Bladeson01/SMS-II-RGB-to-YPbPr/(list of files, cad)

Other CAD files:
lumberg_1503_13.stp
