Bladeson01/SMS-II-RGB-to-YPbPr/SMSII_Componentv3.kicad_pcb

## KiCad design SMSII_Componentv3.kicad_pcb (2021-07-04)

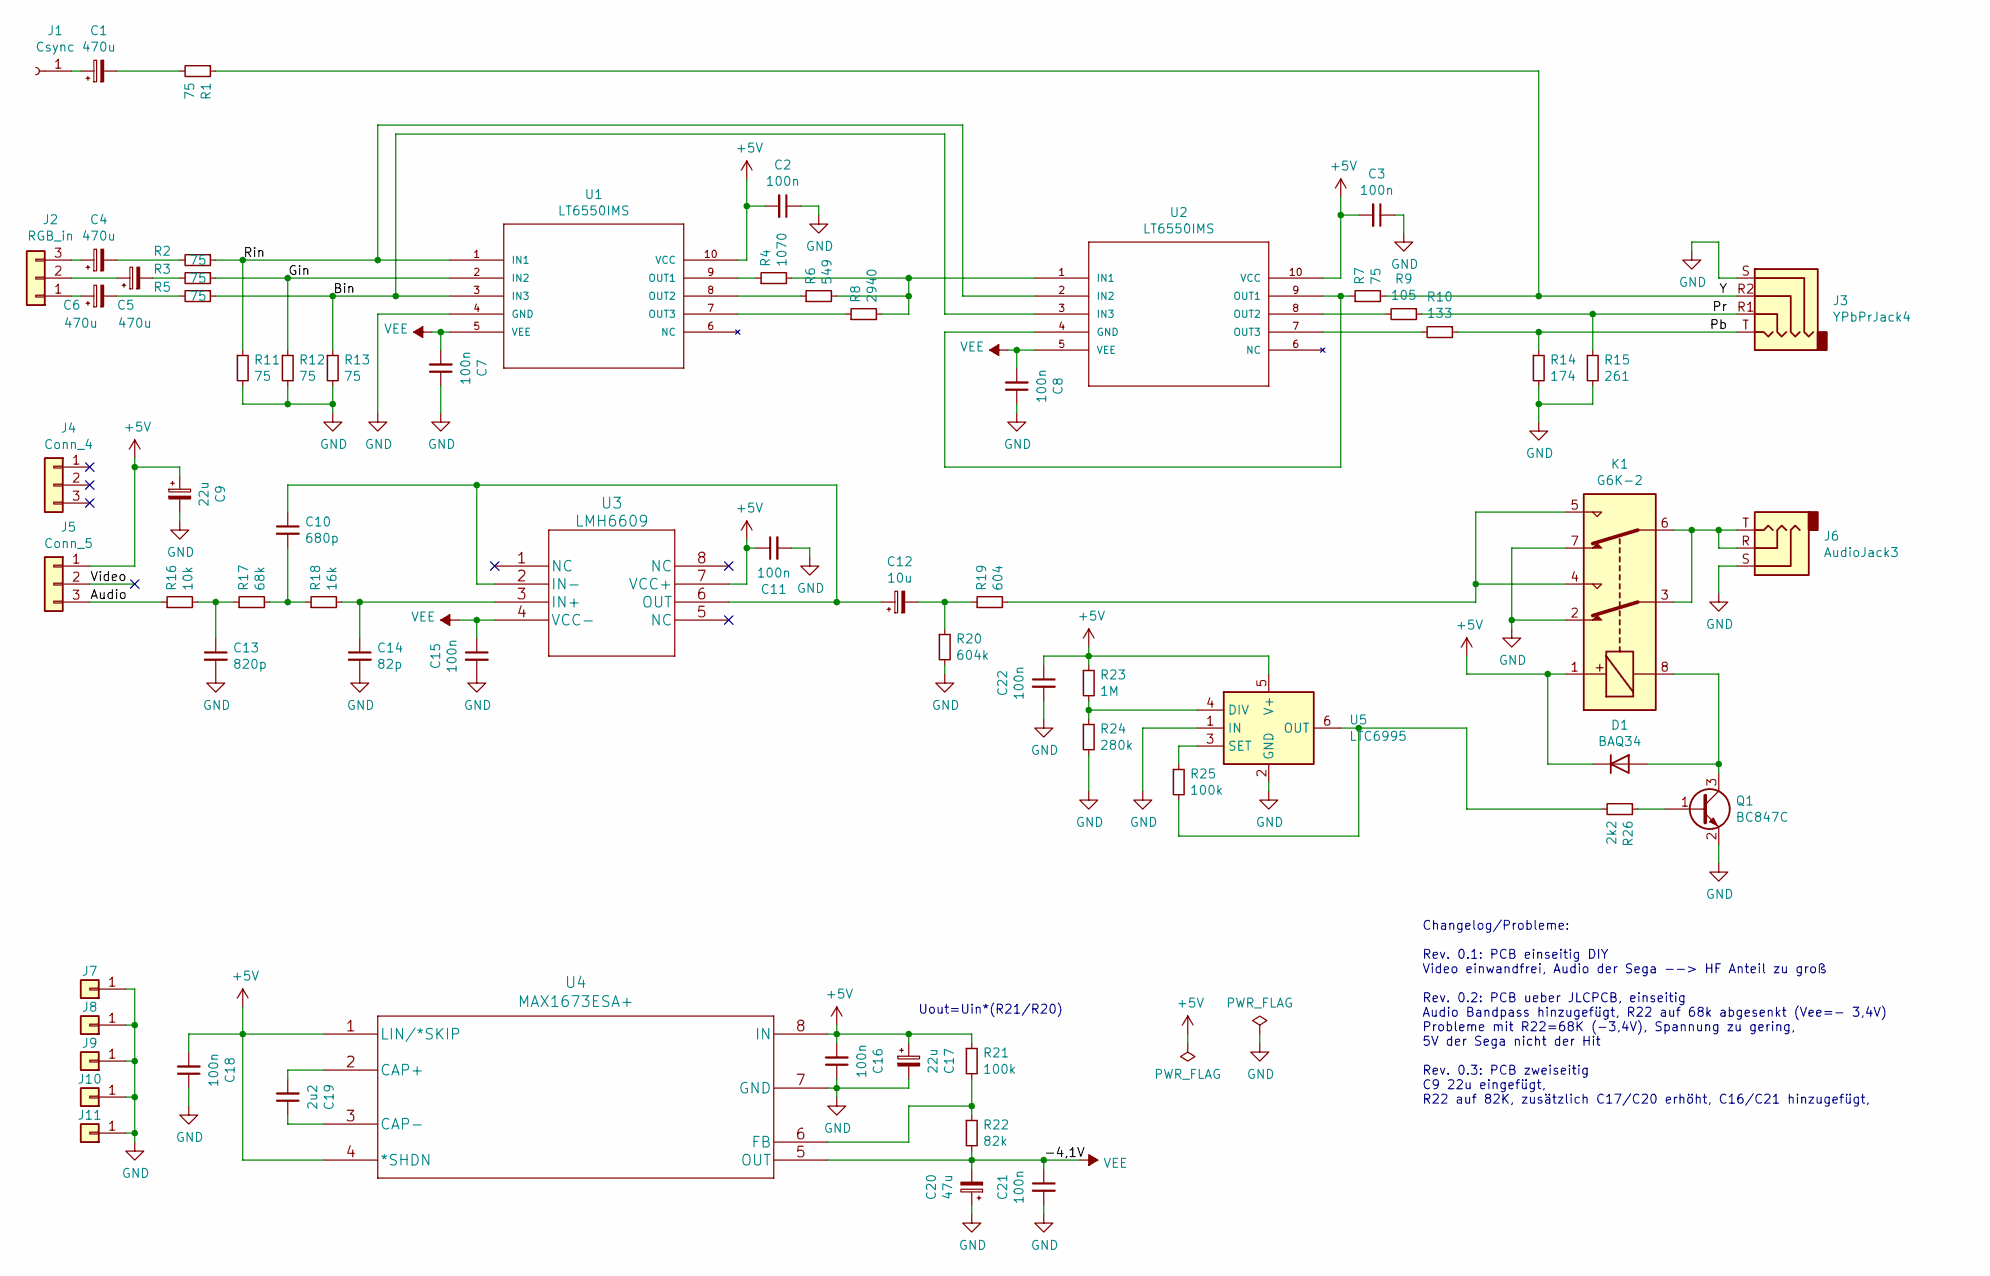
[picture p1: schematic SMSII_Componentv3.sch, SegaMS II -RGB to YPbPr]

Parts:
C1, C4, C5, C6: 470u; CP_Elec_6.3x7.7; LCSC C344072
C2, C3, C7, C8, C11, C15, C16, C18, C21, C22: 100n; C_0603_1608Metric_Pad1.05x0.95mm_HandSolder; LCSC C1591
C9, C17: 22u; CP_Elec_5x5.8; LCSC C336306
C10: 680p; C_0603_1608Metric_Pad1.05x0.95mm_HandSolder
C12: 10u; CP_Elec_4x5.8; LCSC C343907
C13: 820p; C_0603_1608Metric_Pad1.05x0.95mm_HandSolder
C14: 82p; C_0603_1608Metric_Pad1.05x0.95mm_HandSolder; LCSC C107056
C19: 2u2; C_0603_1608Metric_Pad1.05x0.95mm_HandSolder; LCSC C162273
C20: 47u; CP_Elec_6.3x5.8; LCSC C249507
D1: BAQ34; D_MiniMELF
J1: Csync; TestPoint_Pad_D2.0mm
J2: RGB_in; PinHeader_1x03_P2.54mm_Vertical
J3: YPbPrJack4; Jack_3.5mm_SMT_Lumberg_13
J4: Conn_4; PinHeader_1x03_P2.54mm_Vertical
J5: Conn_5; PinHeader_1x03_P2.54mm_Vertical
J6: AudioJack3; Jack_3.5mm_3p_SMT_Lumberg
J7, J8, J9, J10, J11: GND; PinHeader_1x01_P2.54mm_Vertical
K1: G6K-2; Relay_DPDT_Omron_G6K-2G-Y
Q1: BC847C; SOT-323_SC-70
R1, R2, R3, R5, R7, R11, R12, R13: 75; R_0603_1608Metric_Pad1.05x0.95mm_HandSolder; LCSC C218142
R4: 1070; R_0603_1608Metric_Pad1.05x0.95mm_HandSolder; LCSC C217842
R6: 549; R_0603_1608Metric_Pad1.05x0.95mm_HandSolder; LCSC C218072
R8: 2940; R_0603_1608Metric_Pad1.05x0.95mm_HandSolder; LCSC C217948
R9: 105; R_0603_1608Metric_Pad1.05x0.95mm_HandSolder; LCSC C217685
R10: 133; R_0603_1608Metric_Pad1.05x0.95mm_HandSolder; LCSC C217726
R14: 174; R_0603_1608Metric_Pad1.05x0.95mm_HandSolder; LCSC C217819
R15: 261; R_0603_1608Metric_Pad1.05x0.95mm_HandSolder; LCSC C217913
R16: 10k; R_0603_1608Metric_Pad1.05x0.95mm_HandSolder; LCSC C128781
R17: 68k; R_0603_1608Metric_Pad1.05x0.95mm_HandSolder; LCSC C425645
R18: 16k; R_0603_1608Metric_Pad1.05x0.95mm_HandSolder; LCSC C217760
R19: 604; R_0603_1608Metric_Pad1.05x0.95mm_HandSolder; LCSC C218096
R20: 604k; R_0603_1608Metric_Pad1.05x0.95mm_HandSolder; LCSC C218095
R21: 100k; R_0603_1608Metric_Pad1.05x0.95mm_HandSolder; LCSC C217682
R22: 82k; R_0603_1608Metric_Pad1.05x0.95mm_HandSolder; LCSC C218159
R23: 1M; R_0603_1608Metric_Pad1.05x0.95mm_HandSolder; LCSC C218095
R24: 280k; R_0603_1608Metric_Pad1.05x0.95mm_HandSolder; LCSC C218095
R25: 100k; R_0603_1608Metric_Pad1.05x0.95mm_HandSolder; LCSC C218095
R26: 2k2; R_0603_1608Metric_Pad1.05x0.95mm_HandSolder; LCSC C218095
U1, U2: LT6550IMS; MSOP-10_MS; LCSC C673138
U3: LMH6609; TL971ID; LCSC C1346629
U4: MAX1673ESA+; MAX1673ESA&plus_; LCSC C143369
U5: LTC6995; TSOT-23-6

Connections:
+5V: C2.2, C3.2, C9.1, C11.1, C16.2, C17.1, C18.2, C22.1, D1.1 (K), J5.1, K1.1, R21.1, R23.1, U1.10 (VCC), U2.10 (VCC), U3.7 (VCC+), U4.1 (LIN/*SKIP), U4.4 (*SHDN), U4.8 (IN), U5.5 (V+)
/Audio: J5.3, R16.1
/Bin: R5.1, R13.1, U1.3 (IN3), U2.3 (IN3)
/Gin: R3.1, R12.1, U1.2 (IN2)
/Pb: J3.T, R10.1, R14.1
/Pr: J3.R1, R9.1, R15.1
/Rin: R2.1, R11.1, U1.1 (IN1), U2.2 (IN2)
/Video: J5.2
/Y: J3.R2, R1.1, R7.2
GND: C2.1, C3.1, C7.1, C8.1, C9.2, C11.2, C13.2, C14.2, C15.2, C16.1, C17.2, C18.1, C20.1, C21.2, C22.2, J3.S, J6.S, J7.1, J8.1, J9.1, J10.1, J11.1, K1.2, K1.7, Q1.2 (E), R11.2, R12.2, R13.2, R14.2, R15.2, R20.2, R24.2, U1.4 (GND), U4.7 (GND), U5.1 (IN), U5.2 (GND)
unnamed: C1.1, J1.1
unnamed: C1.2, R1.2
unnamed: C4.1, J2.3
unnamed: C4.2, R2.2
unnamed: C5.1, J2.2
unnamed: C5.2, R3.2
unnamed: C6.1, J2.1
unnamed: C6.2, R5.2
unnamed: C10.1, C12.1, U3.2 (IN-), U3.6 (OUT)
unnamed: C10.2, R17.2, R18.1
unnamed: C12.2, R19.1, R20.1
unnamed: C13.1, R16.2, R17.1
unnamed: C14.1, R18.2, U3.3 (IN+)
unnamed: C19.1, U4.3 (CAP-)
unnamed: C19.2, U4.2 (CAP+)
unnamed: D1.2 (A), K1.8, Q1.3 (C)
unnamed: J6.R, J6.T, K1.3, K1.6
unnamed: K1.4, K1.5, R19.2
unnamed: Q1.1 (B), R26.1
unnamed: R4.1, U1.9 (OUT1)
unnamed: R4.2, R6.2, R8.2, U2.1 (IN1)
unnamed: R6.1, U1.8 (OUT2)
unnamed: R7.1, U2.4 (GND), U2.9 (OUT1)
unnamed: R8.1, U1.7 (OUT3)
unnamed: R9.2, U2.8 (OUT2)
unnamed: R10.2, U2.7 (OUT3)
unnamed: R21.2, R22.1, U4.6 (FB)
unnamed: R23.2, R24.1, U5.4 (DIV)
unnamed: R25.1, U5.3 (SET)
unnamed: R25.2, R26.2, U5.6 (OUT)
VEE: C7.2, C8.2, C15.1, C20.2, C21.1, R22.2, U1.5 (VEE), U2.5 (VEE), U3.4 (VCC-), U4.5 (OUT)

Notes on the sheet:
Uout=Uin*(R21/R20)
Changelog/Probleme: Rev. 0.1: PCB einseitig DIY Video einwandfrei, Audio der Sega --> HF Anteil zu groß Rev. 0.2: PCB ueber JLCPCB, einseitig Audio Bandpass hinzugefügt, R22 auf 68k abgesenkt (Vee=- 3,4V) Probleme mit R22=68K (-3,4V), Spannung zu gering, 5V der Sega nicht der Hit Rev. 0.3: PCB zwei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

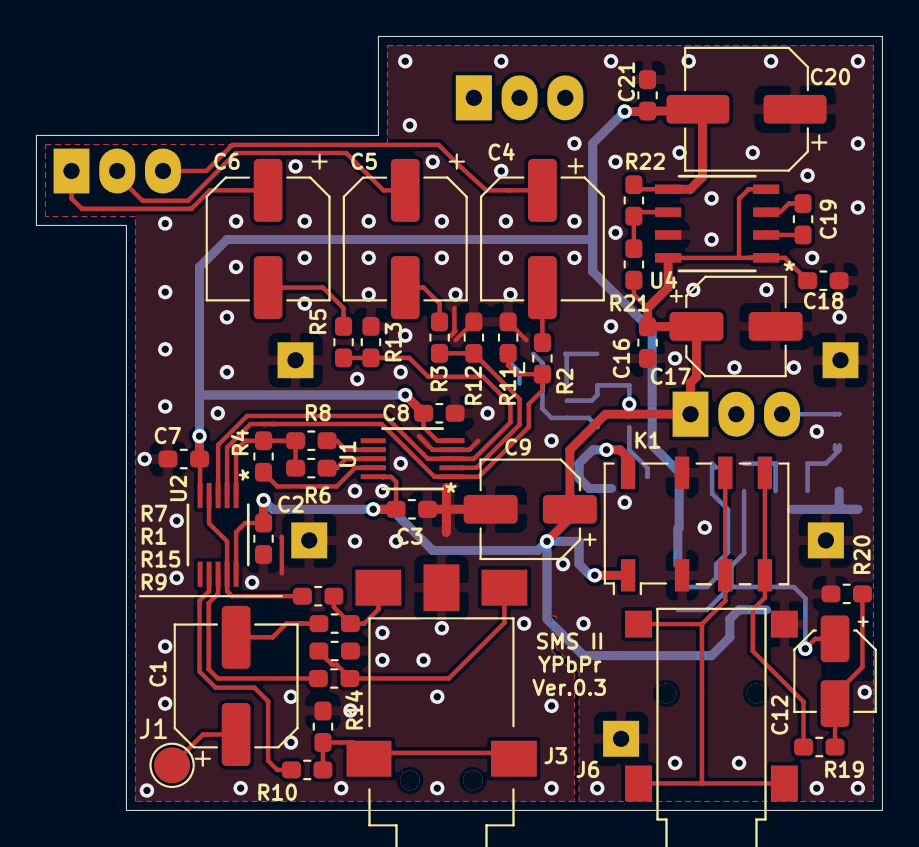
[picture p2: board SMSII_Componentv3.kicad_pcb from above]

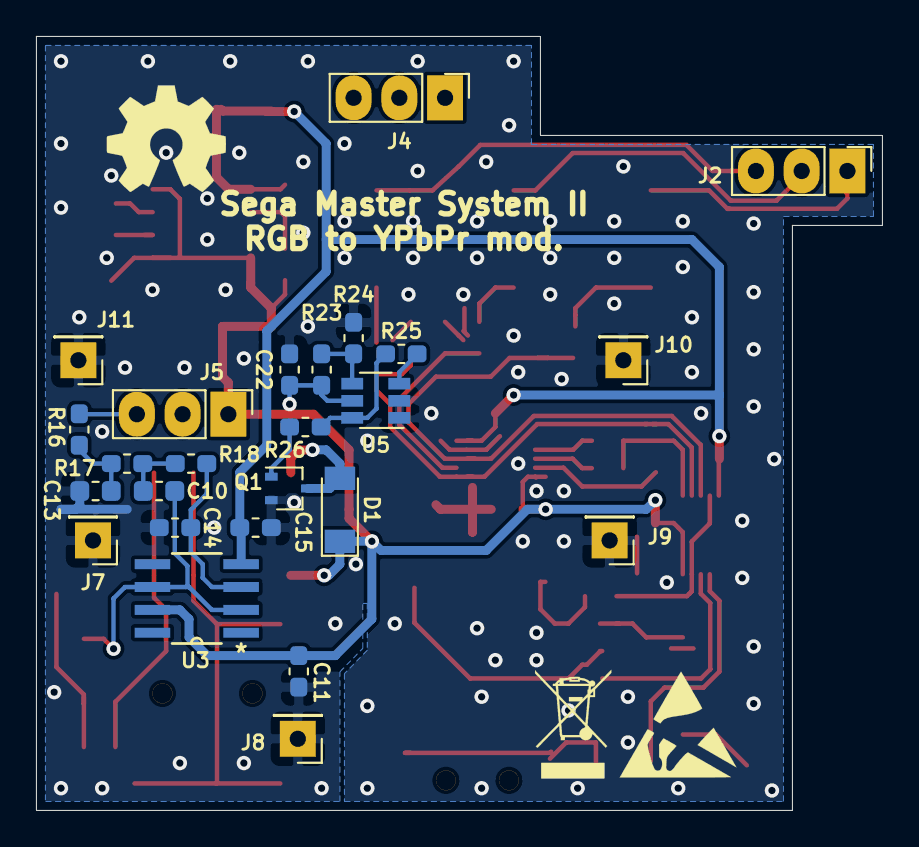
[picture p3: board SMSII_Componentv3.kicad_pcb from below]

Board: 2 copper layers, 47.0 x 43.0 mm, 67 parts (25 on the bottom side), 40 nets.
