Bladeson01/SMS-II-RGB-to-YPbPr/(notices)

Notices in the files:
parts and their libraries:
Copyright C 2016 Accelerated Designs. All rights reserved
Copyright 2016 Accelerated Designs. All rights reserved.
